ToshiSoftware/N-Gauge-PICO2W/README.md

# N gauge model tram/train layout automatic operation system

This project includes an N gauge model tram/train controller and an autonomous driving system using Raspberry Pi Pico 2 W.

## Design data

See the file: https://github.com/ToshiSoftware/N-Gauge-PICO2W/blob/main/docs/AboutFilesHere.md

## YouTube

A video of the system in action can be found here:

[Autonomous N Gauge Model Tram/Train Layout in Action | Raspberry Pi Pico + Touchscreen Control](https://youtu.be/R6ILkEr7j3k?si=v2wnCct7QF6oFGn6)

A video of the diorama and the tram running here (No speach and subtitle):

[A3サイズの箱庭鉄道模型レイアウト 伊予鉄道 (風景編)](https://youtu.be/IACruLuuN5w)
