ToshiSoftware/N-Gauge-PICO2W/docs/layout_structure_diagram.pdf

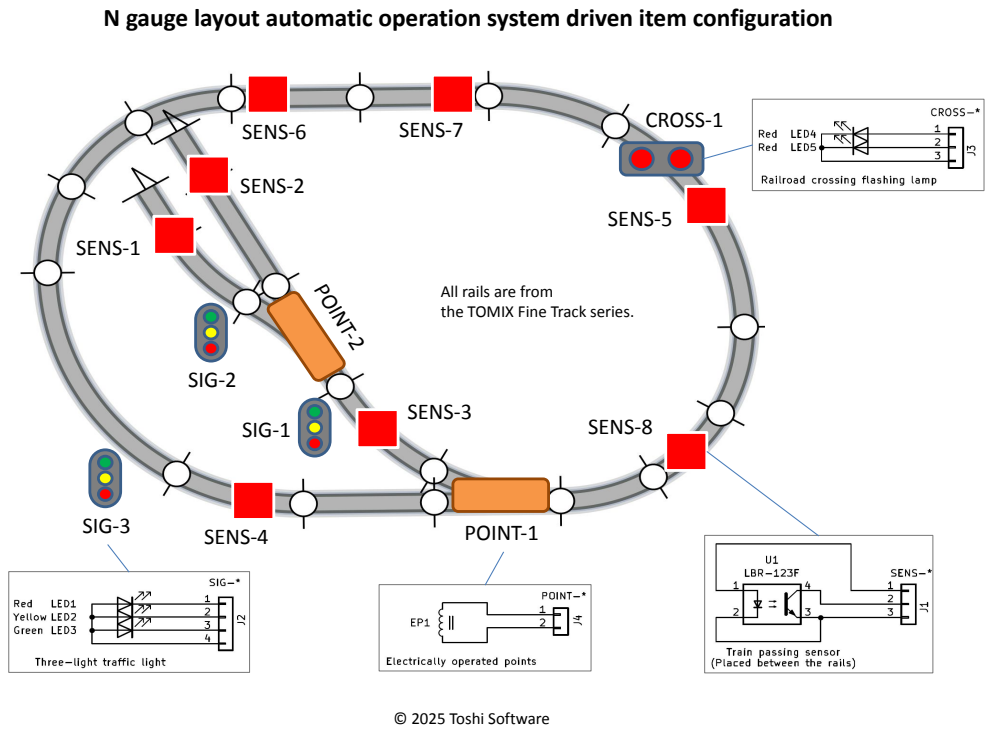
[picture p1: page 1]
SIG-2; SIG-1; SIG-3; SENS-1; SENS-2; SENS-6; SENS-7; SENS-5; SENS-8 SENS-3; SENS-4; CROSS-1; POINT-1; POINT-2; © 2025 Toshi Software

N gauge layout automatic operation system driven item configuration

All rails are from
the TOMIX Fine Track series.
