ToshiSoftware/N-Gauge-PICO2W/docs/pcb_structure.pdf

# N gauge layout automatic operation system hardware configuration

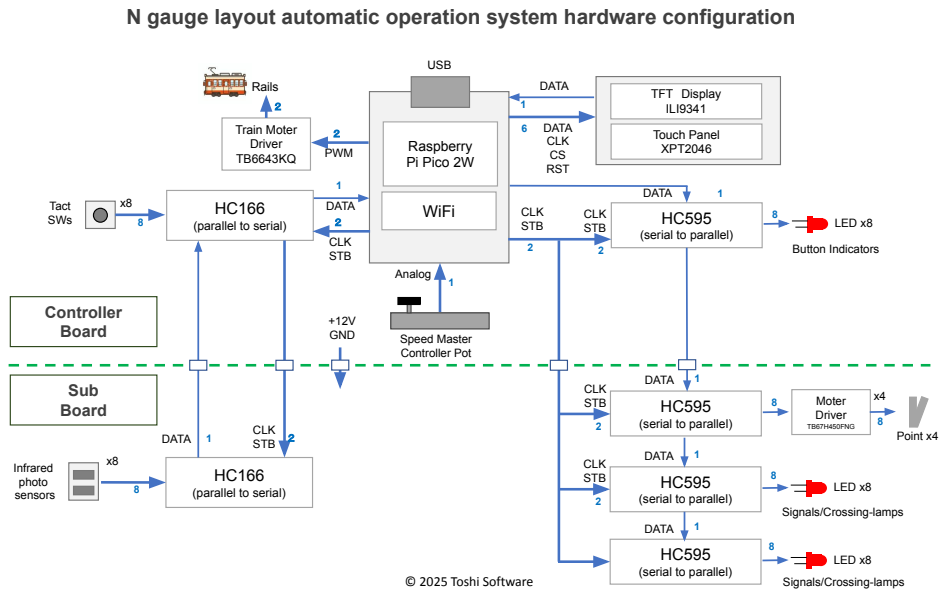
[picture p2: page 1]
Raspberry Pi Pico 2W; TFT Display ILI9341; DATA; (serial to parallel); USB; WiFi; CLK STB; (parallel to serial); LED x8; CLK; STB DATA; Tact SWs; Infrared photo sensors; Analog; Speed Master Controller Pot; Button Indicators; Point x4; Controller Board; Sub Board; Moter Driver; TB67H450FNG; Train Moter Driver TB6643KQ; PWM; Touch Panel XPT2046; DATA CLK CS RST; Rails; +12V GND; © 2025 Toshi Software

(serial to parallel)

(parallel to serial)

Signals/Crossing-lamps
