ToshiSoftware/N-Gauge-PICO2W/docs/connection_schematic.pdf

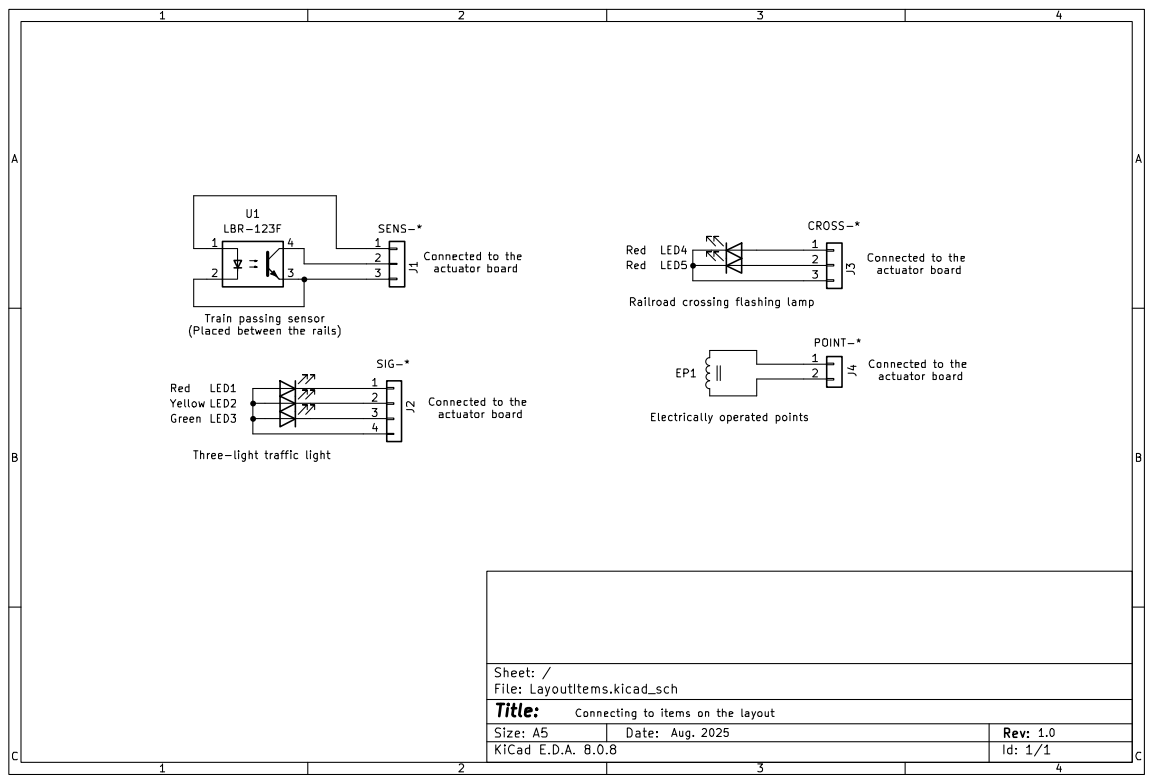
[picture p3: page 1]
