ToshiSoftware/N-Gauge-PICO2W/docs/actuator_schematic.pdf

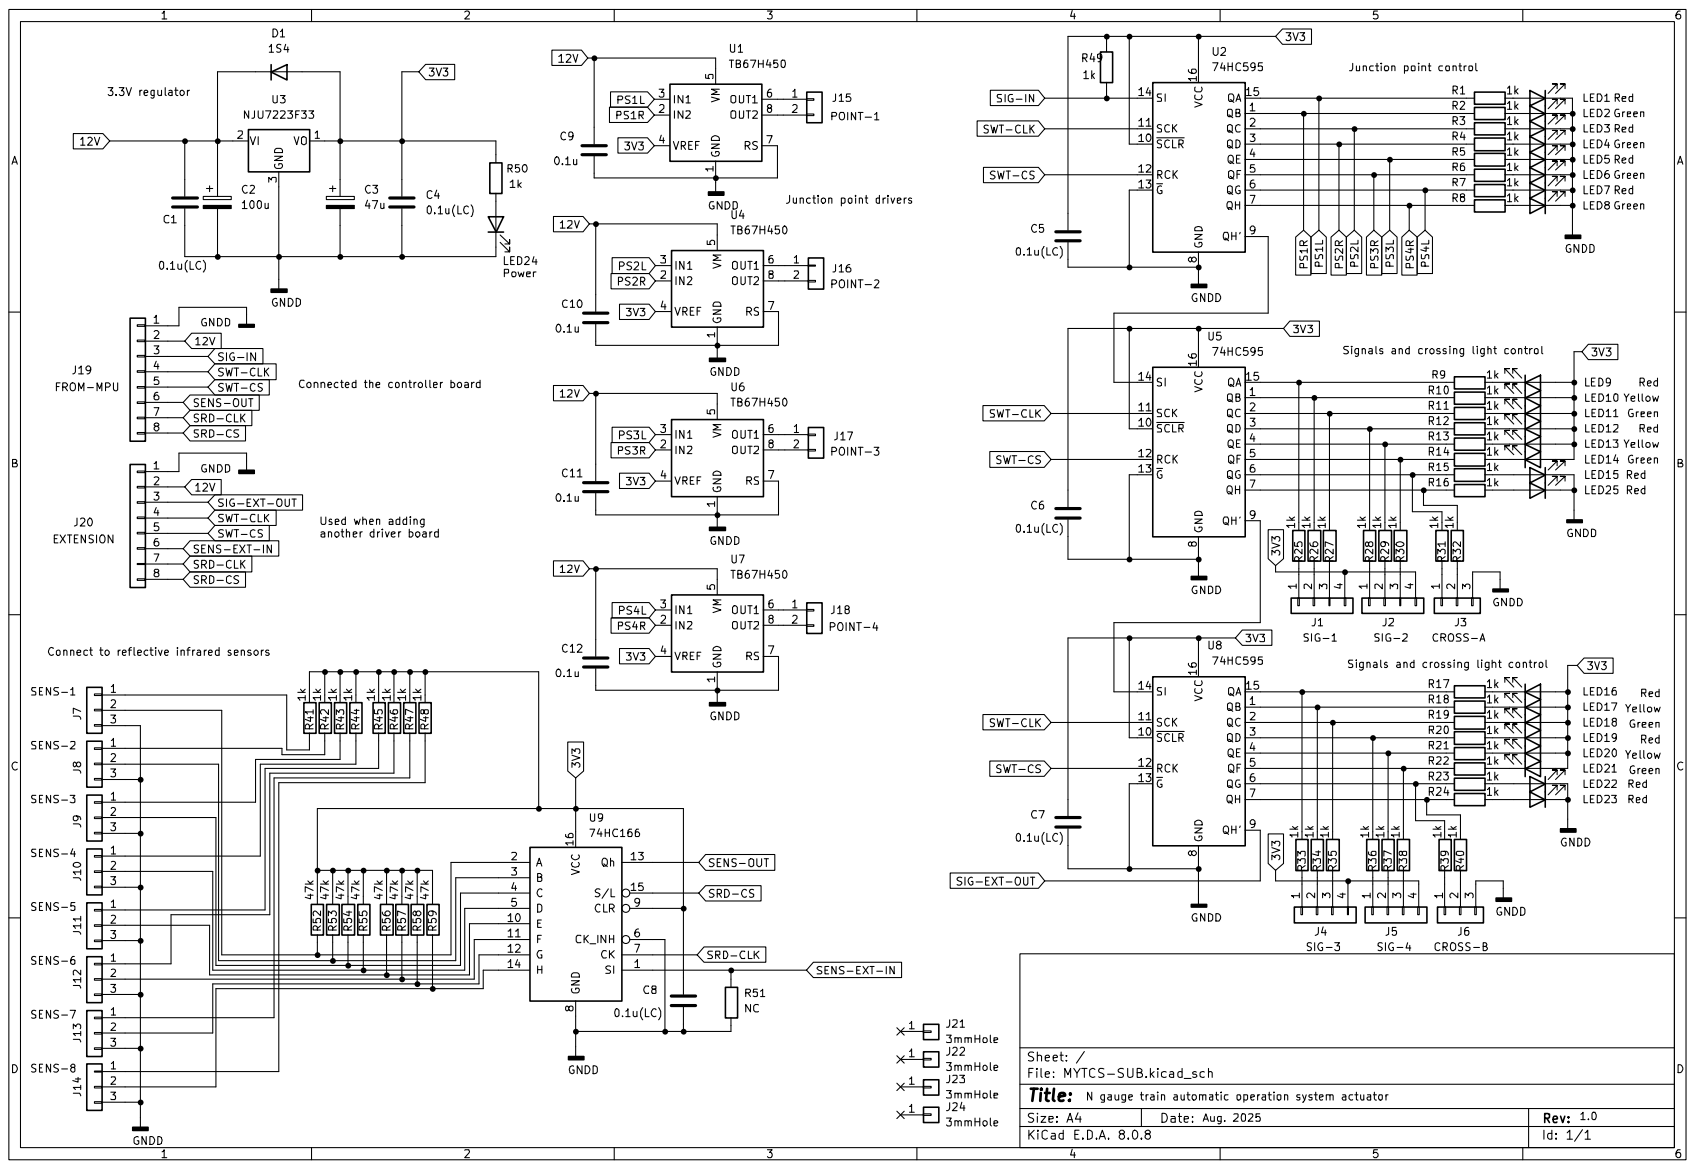
[picture p4: page 1]
