ToshiSoftware/N-Gauge-PICO2W/docs/controller_schematic.pdf

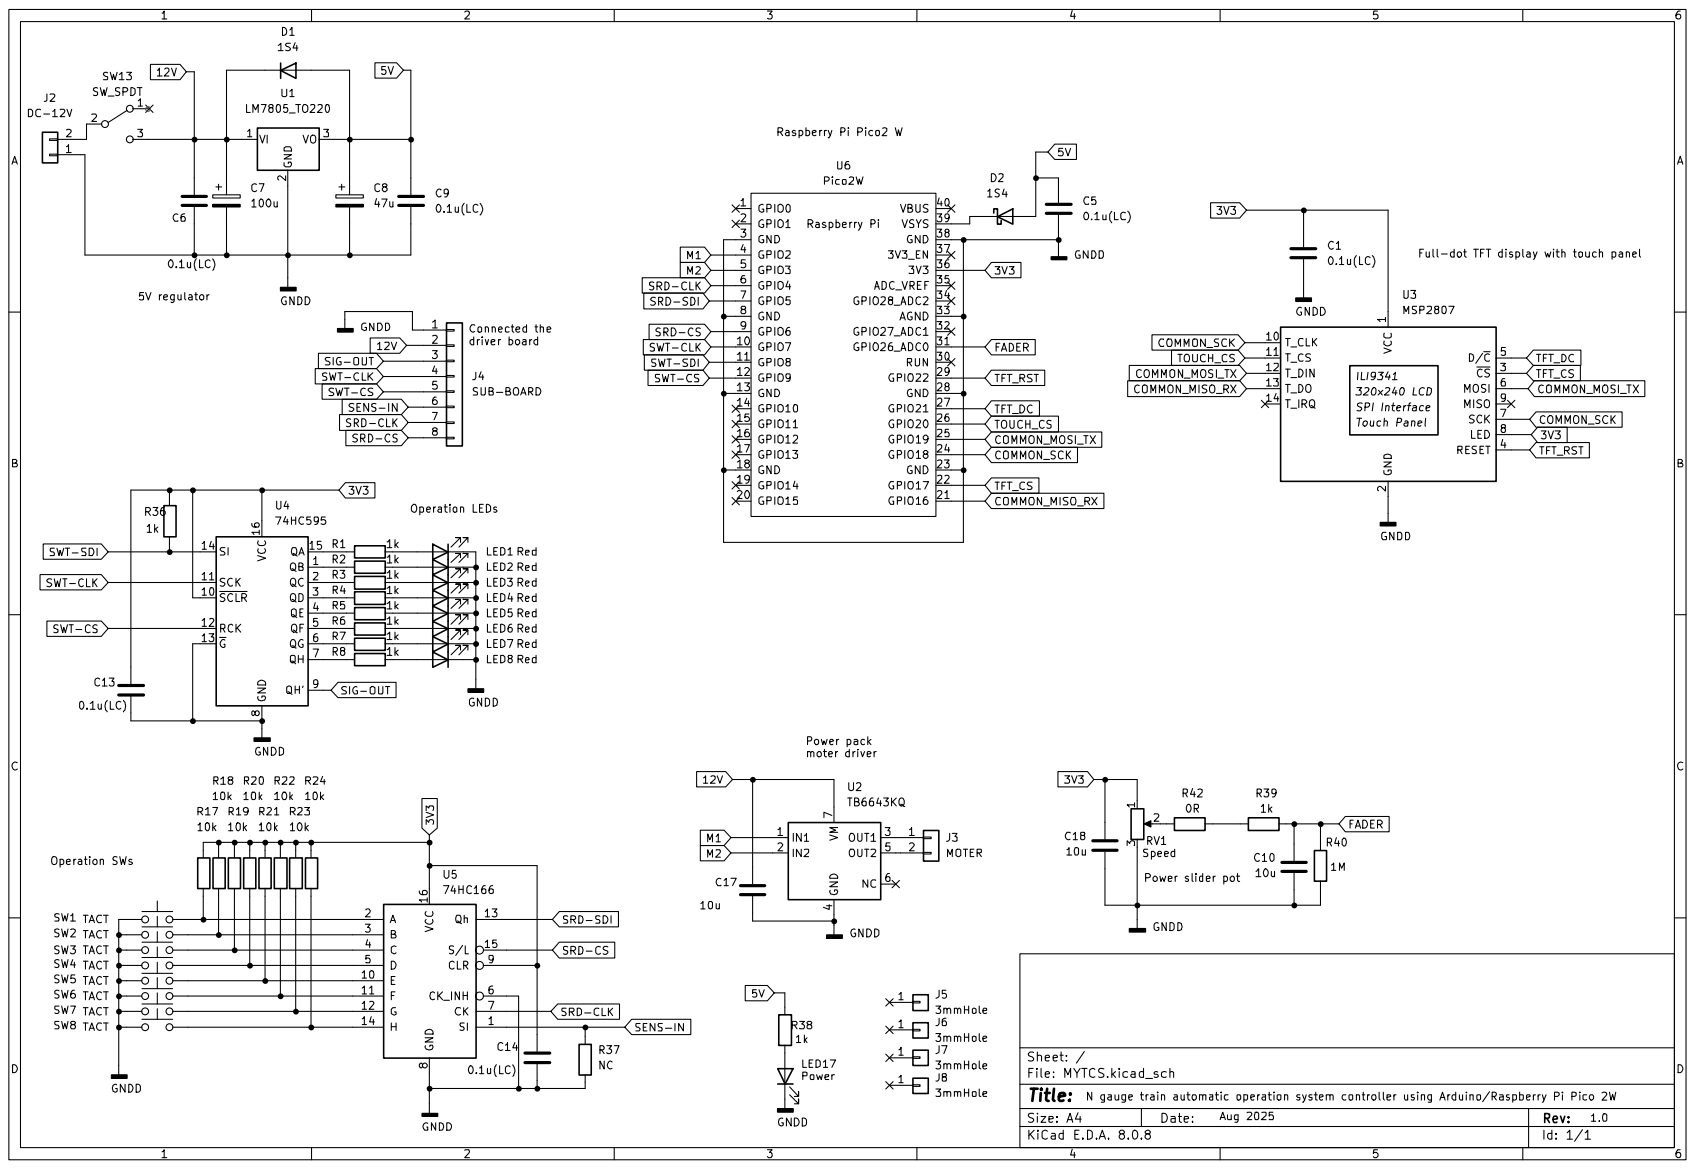
[picture p5: page 1]
