ToshiSoftware/N-Gauge-PICO2W/(commit log)

2025-08-17 Serial device removal
    Removed four control SWs, two encoders and eight speed LEDs from the previous system.
2025-08-17 Add schematic
2025-08-17 Add another schematic
2025-08-17 Add KiCAD PCB data
2025-08-18 Changed to alternate button
2025-08-21 Signal 2 initial state correction
    [systemctrl.ino]
2025-08-21 Add a pdf
    "ItemsOnLayout.pdf" contains the connection schematics for the items on the layout.
2025-08-23 Add the connection schematic
2025-08-23 Delete KICAD_ACTUATOR.zip
    Moved to the docs folder
2025-08-23 Delete KICAD_CONTROLLER.zip
    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
2025-08-23 Delete actuator_schematic.pdf
    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
2025-08-24 Improve interrupt design
2025-08-24 Add PCB structure diagram
